cclaunch/KPgolem/addStrings.ino

//
// place to set up progmem string constants to save space in static RAM
//

unsigned char Cmode[]     PROGMEM = "MODE";
unsigned char Cverify[]   PROGMEM = "VERIFY";
unsigned char Cdiag[]     PROGMEM = "DIAG";
unsigned char Ccode[]     PROGMEM = "CODE";
unsigned char Cload[]     PROGMEM = "LOAD";
unsigned char CASCII[]    PROGMEM = "ASCII";
unsigned char CBINARY[]   PROGMEM = "BINARY";
unsigned char CUSERTAB[]  PROGMEM = "USERTAB";
unsigned char CON[]       PROGMEM = "ON";
unsigned char COFF[]      PROGMEM = "OFF";
unsigned char CBCD[]      PROGMEM = "BCD";
unsigned char CEBCDIC[]   PROGMEM = "EBCDIC";
unsigned char CIDLE[]     PROGMEM = "IDLE";
