cclaunch/KPgolem/(commit log)

2015-01-02 Arduino code files for V2.06beta initial upload
    KeyPunchIntf.ino is the master file to be placed in an Arduino project
    KeyPunchIntf then add the other files which are part of the code but
    modularized for ease of maintenance and understanding.
2015-01-20 Enhancements to intf box code and fixes after testing of PC sw
    [KeyPunchInterface.py, addStrings.ino, doPunch.ino, execCommand.ino, parseCommand.ino]
2015-01-20 Beta release of PC program to drive keypunch
    includes minor fixes and removal of diagnostic print messages from some
    Arduino modules
    [KeyPunchInterface.py, defines.ino, doPunch.ino, execCommand.ino, getCommand.ino]
2015-01-22 User guide draft 0.3
    Documents use of PC program, interface box and reference material. V0.3
    only has the PC program information included
